fedor2018/HX-coffee-machine-controller/images/img_top.jpg

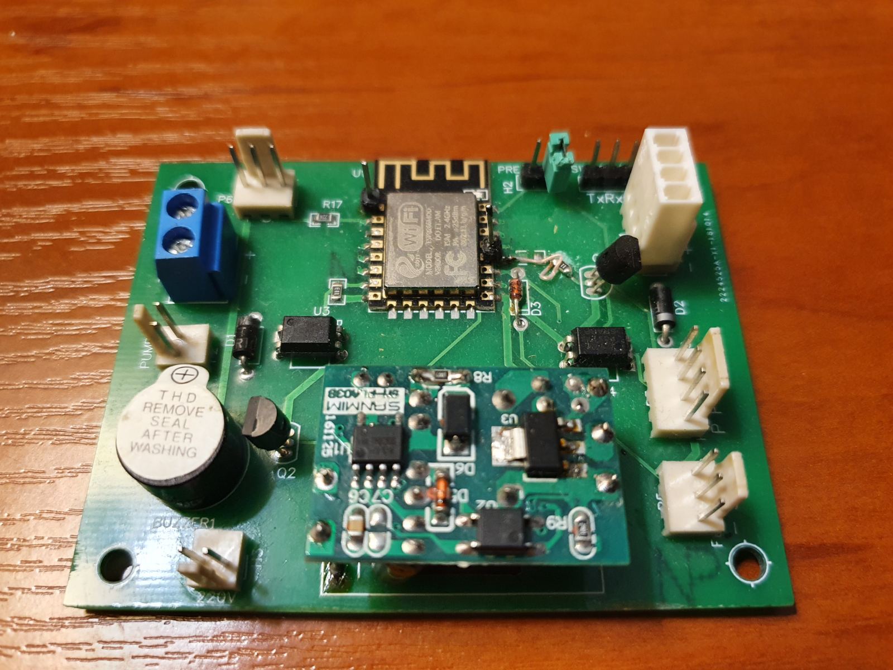
images/img_top.jpg
