fedor2018/HX-coffee-machine-controller/docs/transducer.jpg

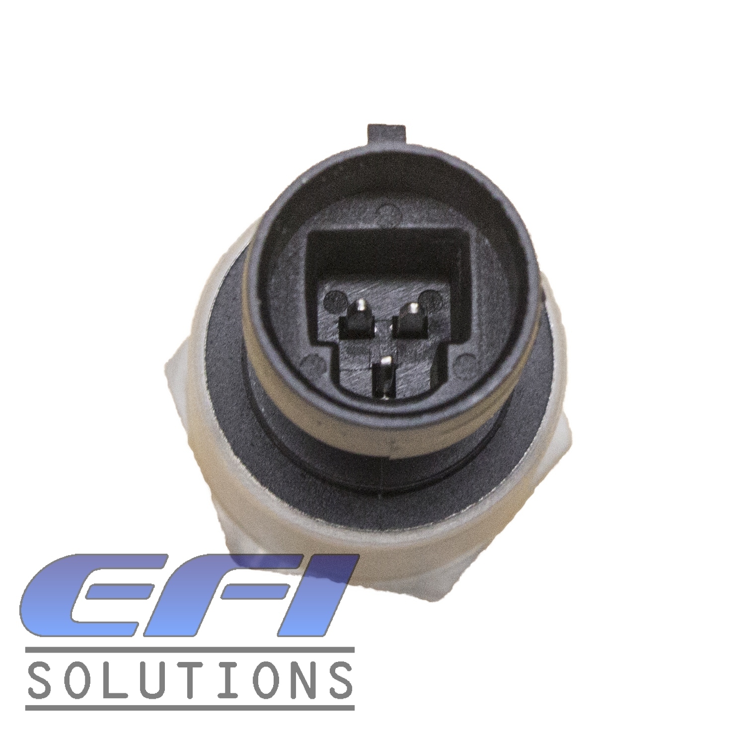
docs/transducer.jpg
