fedor2018/HX-coffee-machine-controller/README.md

# HX-coffee-machine-controller

https://arduino.esp8266.com/stable/package_esp8266com_index.json
