fedor2018/HX-coffee-machine-controller/docs/oled-1.3-I2c.jpg

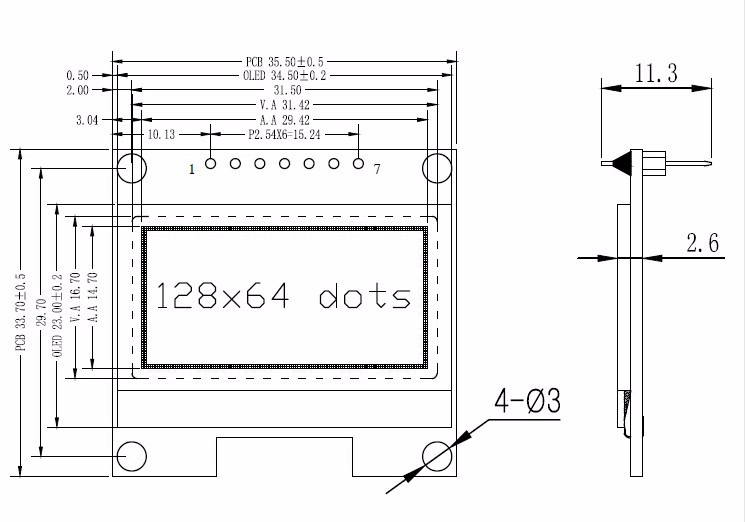
docs/oled-1.3-I2c.jpg
