fedor2018/HX-coffee-machine-controller/docs/transducer1.jpg

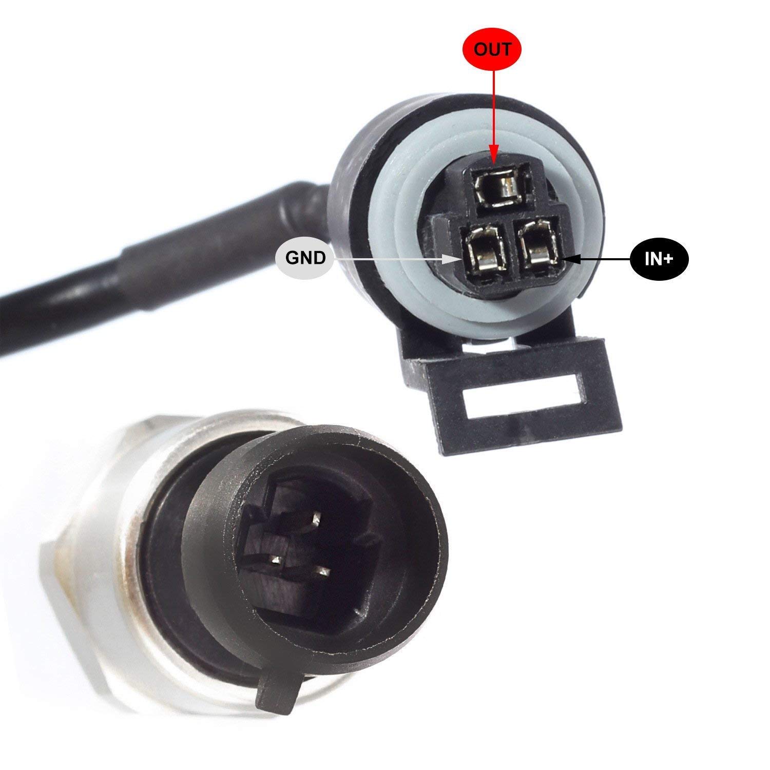
docs/transducer1.jpg
