fedor2018/HX-coffee-machine-controller/docs/transducer3.png

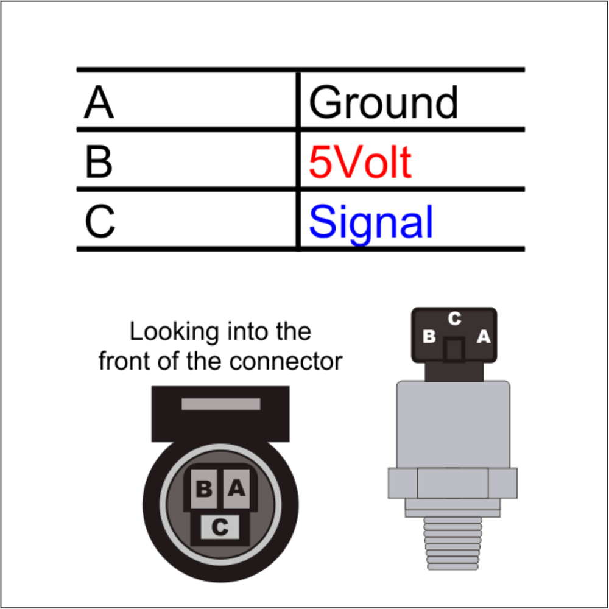
docs/transducer3.png
