fedor2018/HX-coffee-machine-controller/docs/transducer4.png

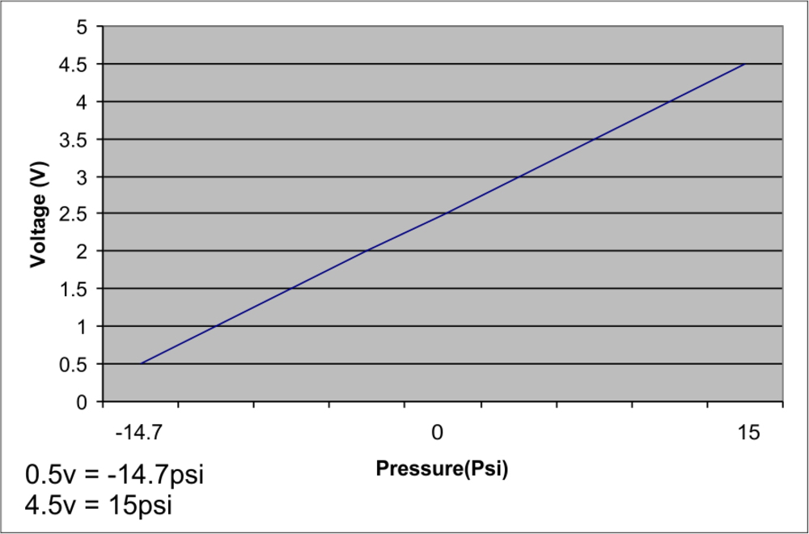
docs/transducer4.png
