fedor2018/HX-coffee-machine-controller/docs/transducer_pinout.png

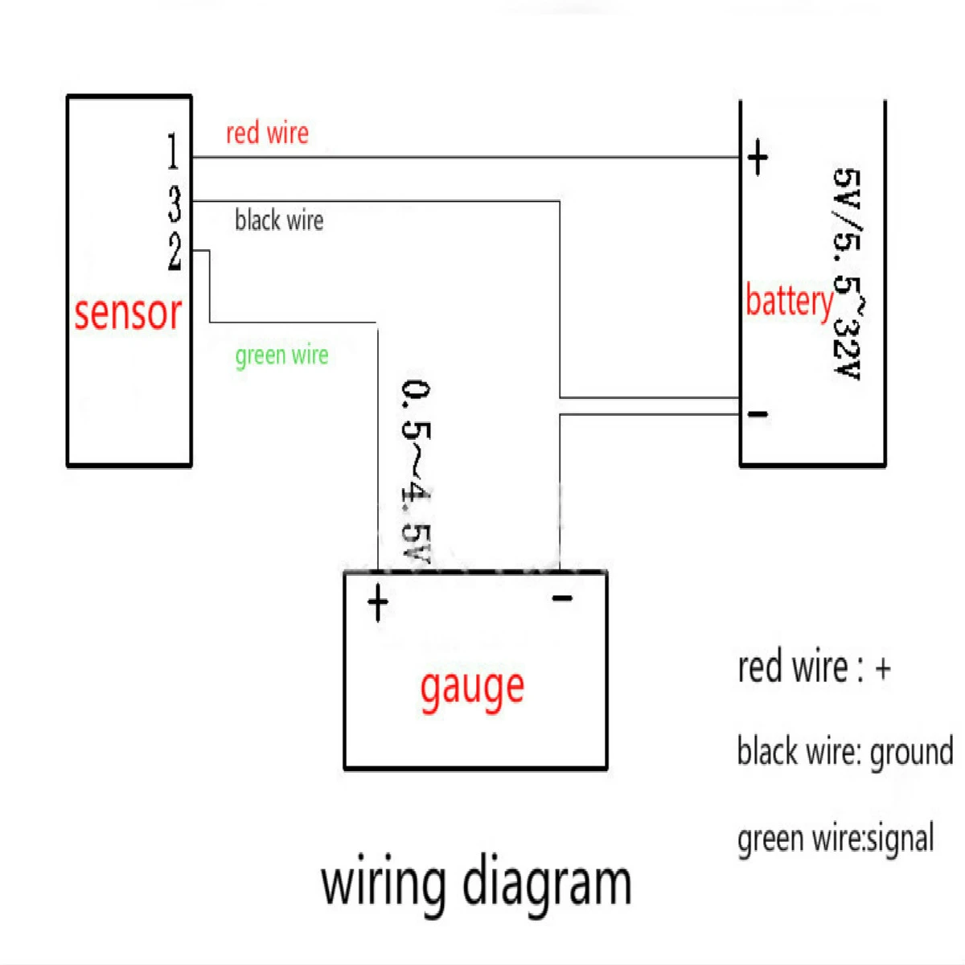
docs/transducer_pinout.png
