fedor2018/HX-coffee-machine-controller/hardware/Schematic_esp_hx copy_2021-06-14.png

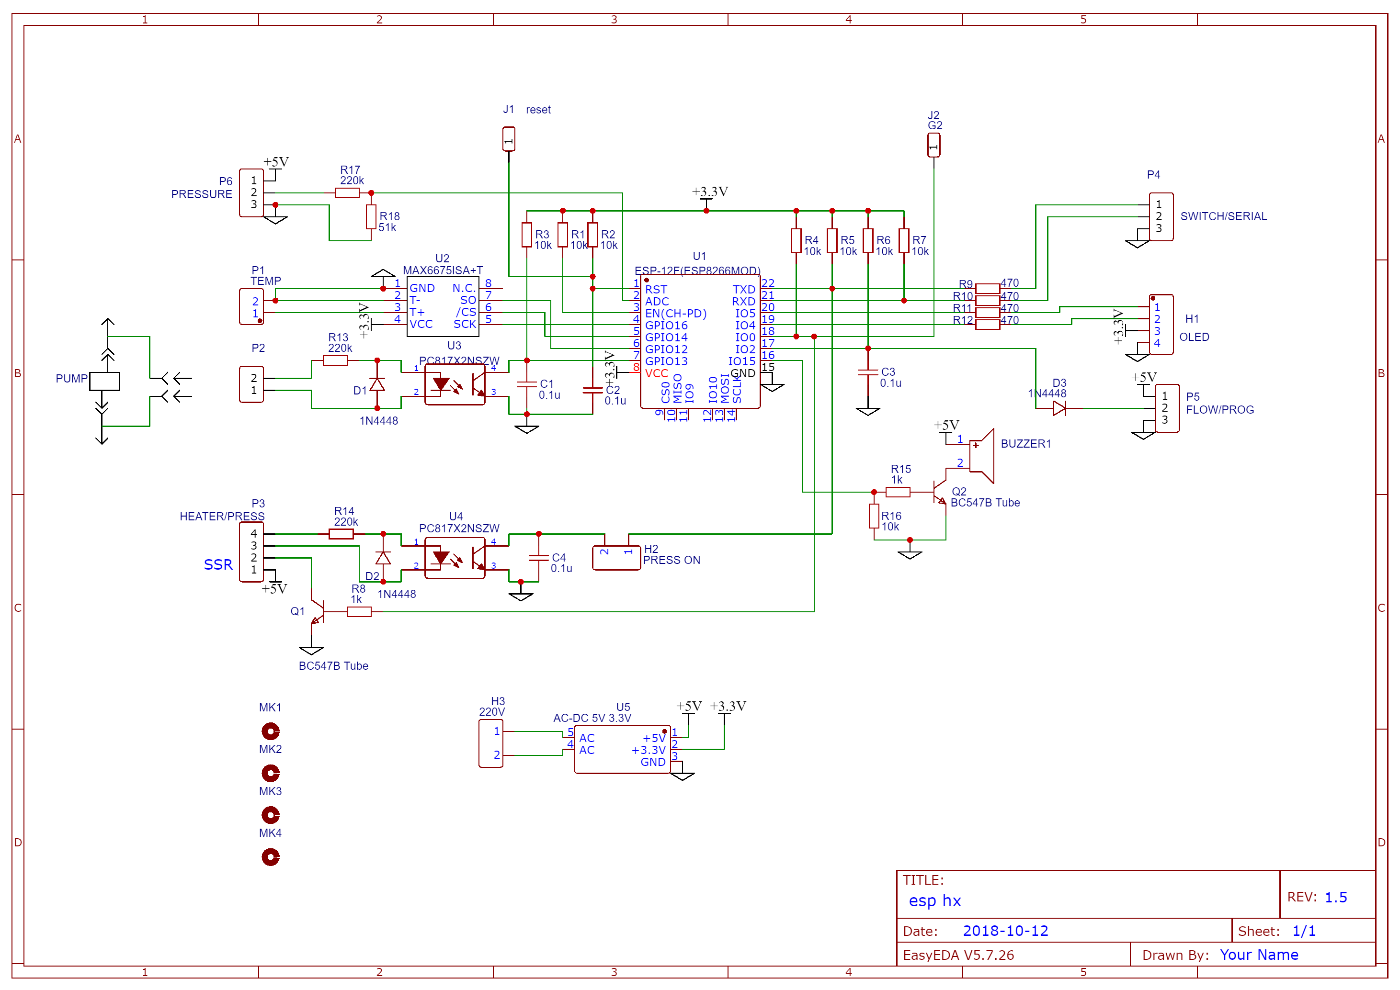
hardware/Schematic_esp_hx copy_2021-06-14.png
