fedor2018/HX-coffee-machine-controller/hardware/Schematic_esp_hx_2021-08-31.png

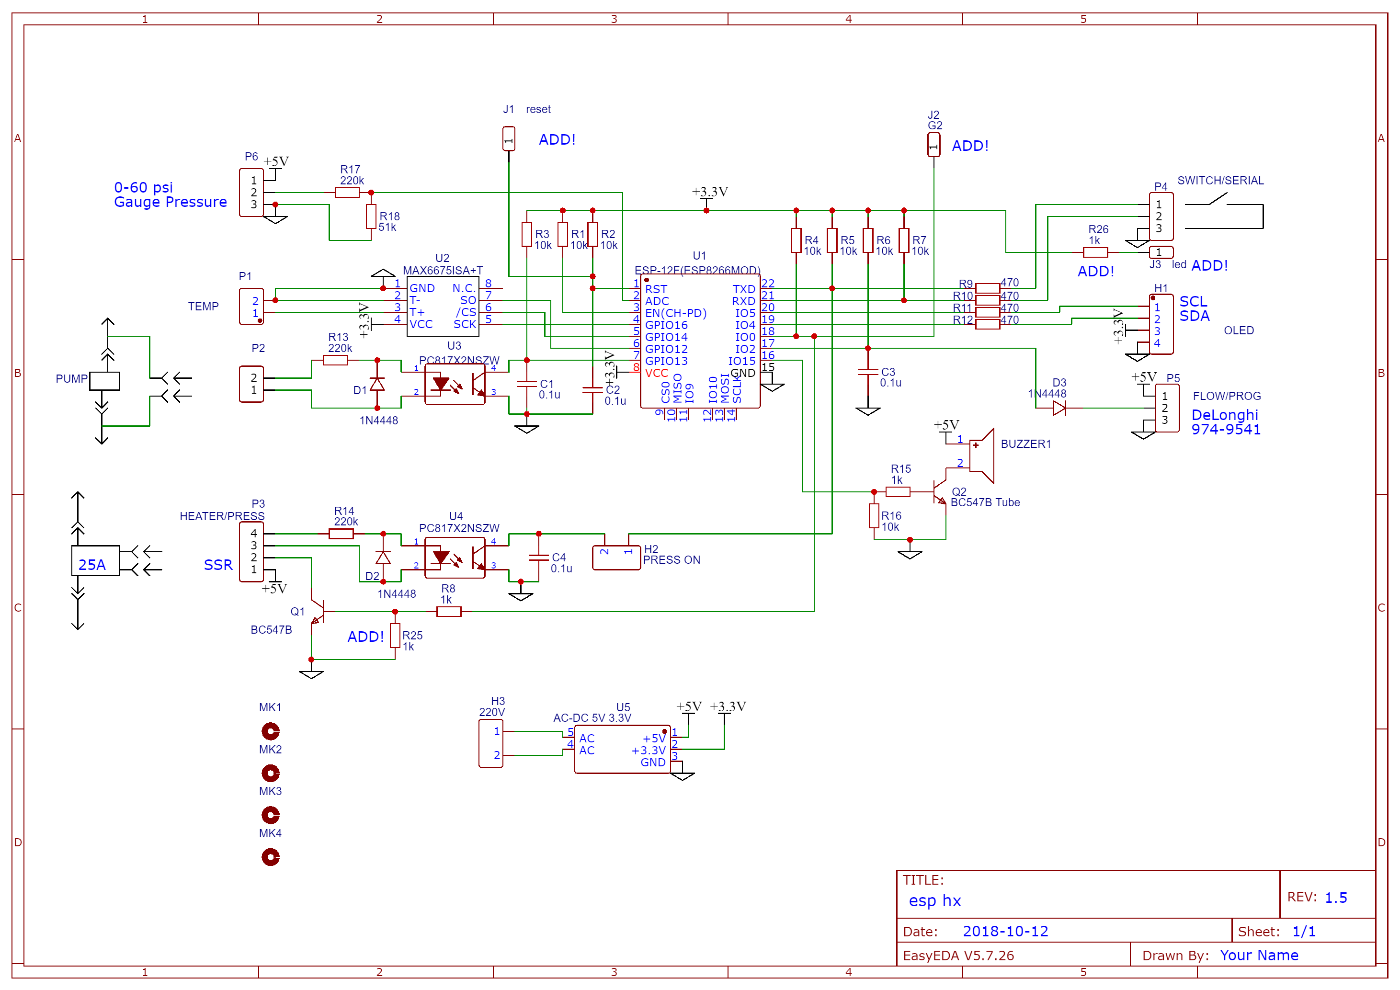
hardware/Schematic_esp_hx_2021-08-31.png
