fedor2018/HX-coffee-machine-controller/images/img_bot.jpg

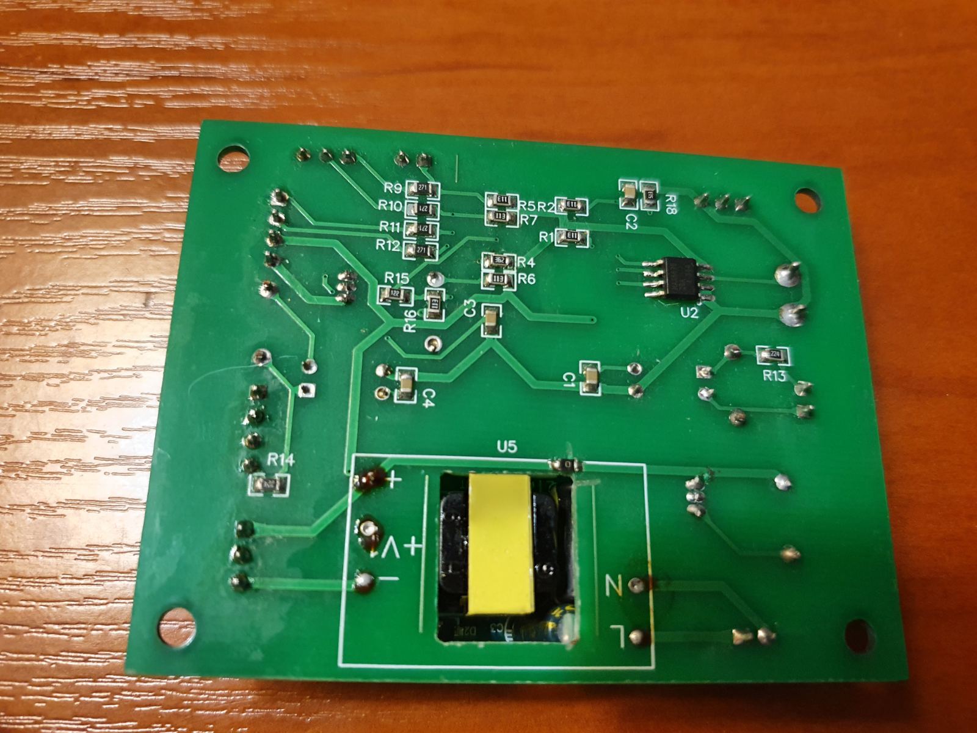
images/img_bot.jpg
